amstan/binaryclock/doc/smpsu_design.pdf

## WEBENCH ® Design Report

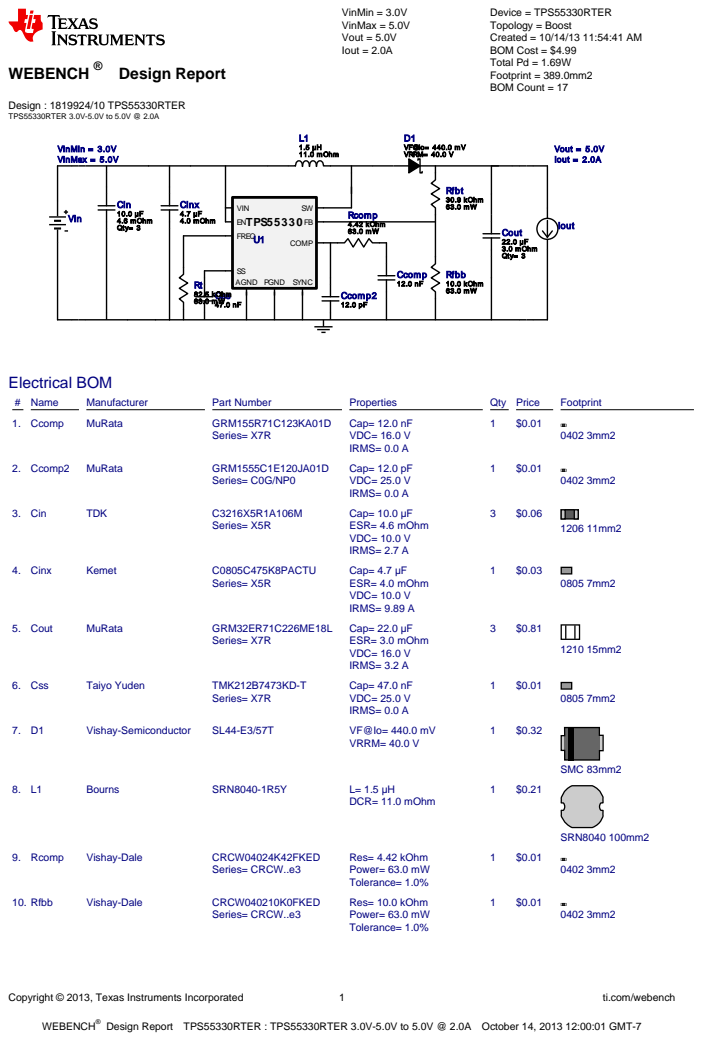
[picture p1: page 1]
Copyright © 2013, Texas Instruments Incorporated; ti.com/webench; WEBENCH®; Design : 1819924/10 TPS55330RTER TPS55330RTER 3.0V-5.0V to 5.0V @ 2.0A; VinMin = 3.0V VinMax = 5.0V Vout = 5.0V Iout = 2.0A; Device = TPS55330RTER Topology = Boost Created = 10/14/13 11:54:41 AM BOM Cost = $4.99 Total Pd = 1.69W Footprint = 389.0mm2 BOM Count = 17; Ccomp 12.0 nF; Ccomp2 12.0 pF; Cinx 4.7 µF 4.0 mOhm; Cout 22.0 µF 3.0 mOhm Qty= 3; Css 47.0 nF; D1 VF@Io= 440.0 mV VRRM= 40.0 V; L1 1.5 µH 11.0 mOhm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

Design Report TPS55330RTER : TPS55330RTER 3.0V-5.0V to 5.0V @ 2.0A October 14, 2013 12:00:01 GMT-7

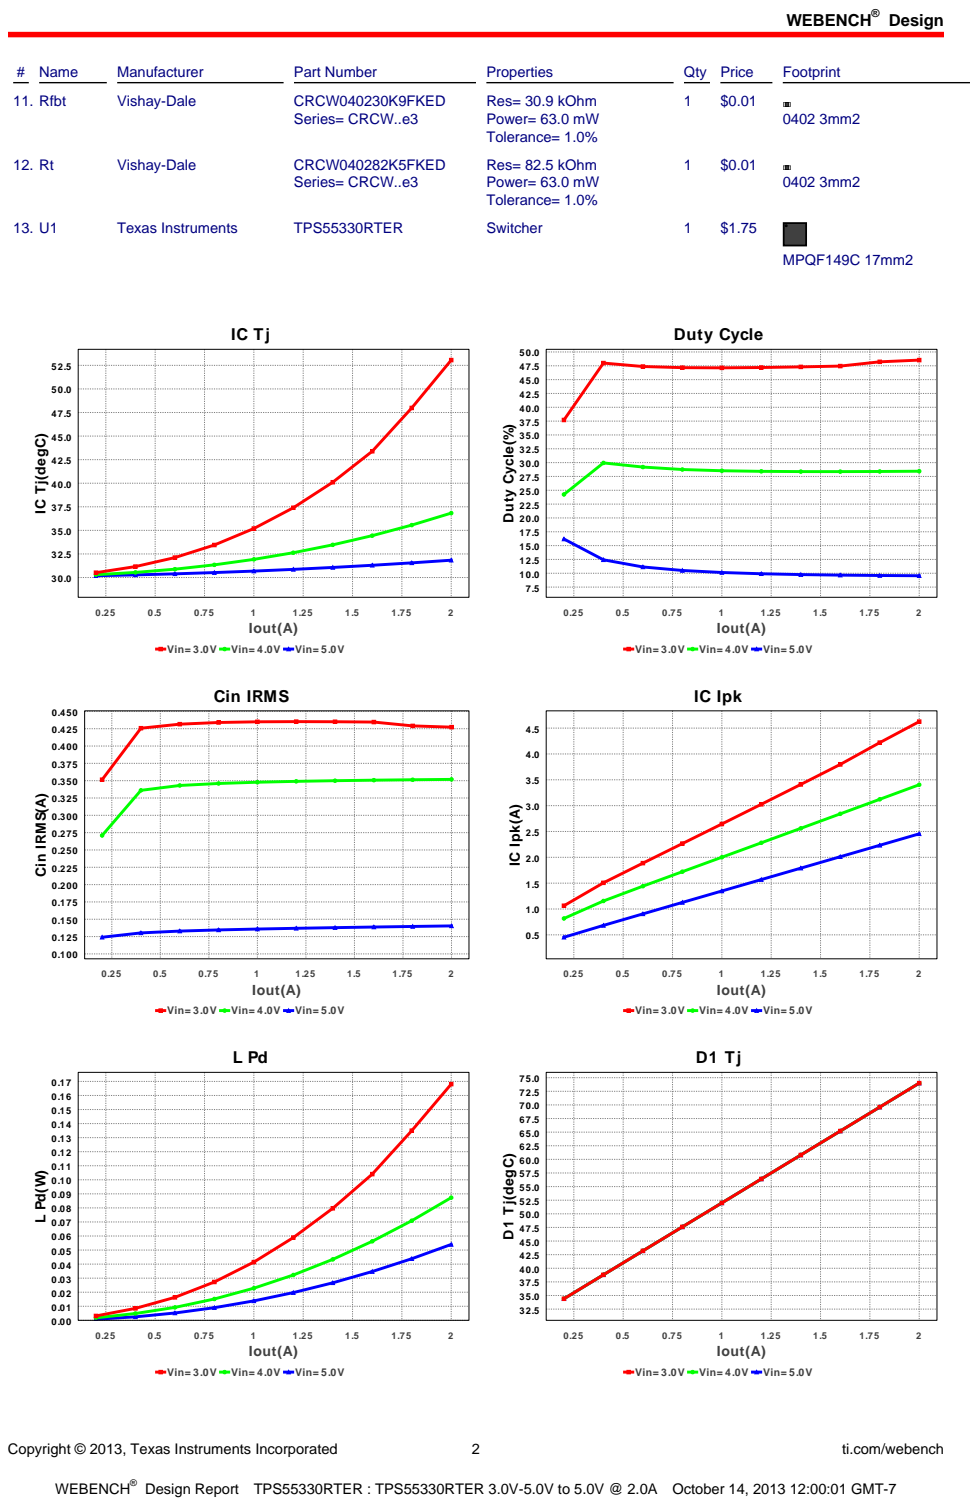
[picture p2: page 2]
Design; Copyright © 2013, Texas Instruments Incorporated; ti.com/webench; # Name; Manufacturer; Part Number; Properties; Qty Price; Footprint; 11. Rfbt; Vishay-Dale; CRCW040230K9FKED; Series= CRCW..e3; Res= 30.9 kOhm Power= 63.0 mW Tolerance= 1.0%; CRCW040282K5FKED; Res= 82.5 kOhm Power= 63.0 mW Tolerance= 1.0%; Texas Instruments; TPS55330RTER; Switcher; MPQF149C 17mm2; Iout(A); Duty Cycle; Duty Cycle(%); Cin IRMS; Cin IRMS(A); IC Ipk; IC Ipk(A); D1 Tj(degC)

IC Tj(degC)

Vin= 3.0V Vin= 4.0V Vin= 5.0V

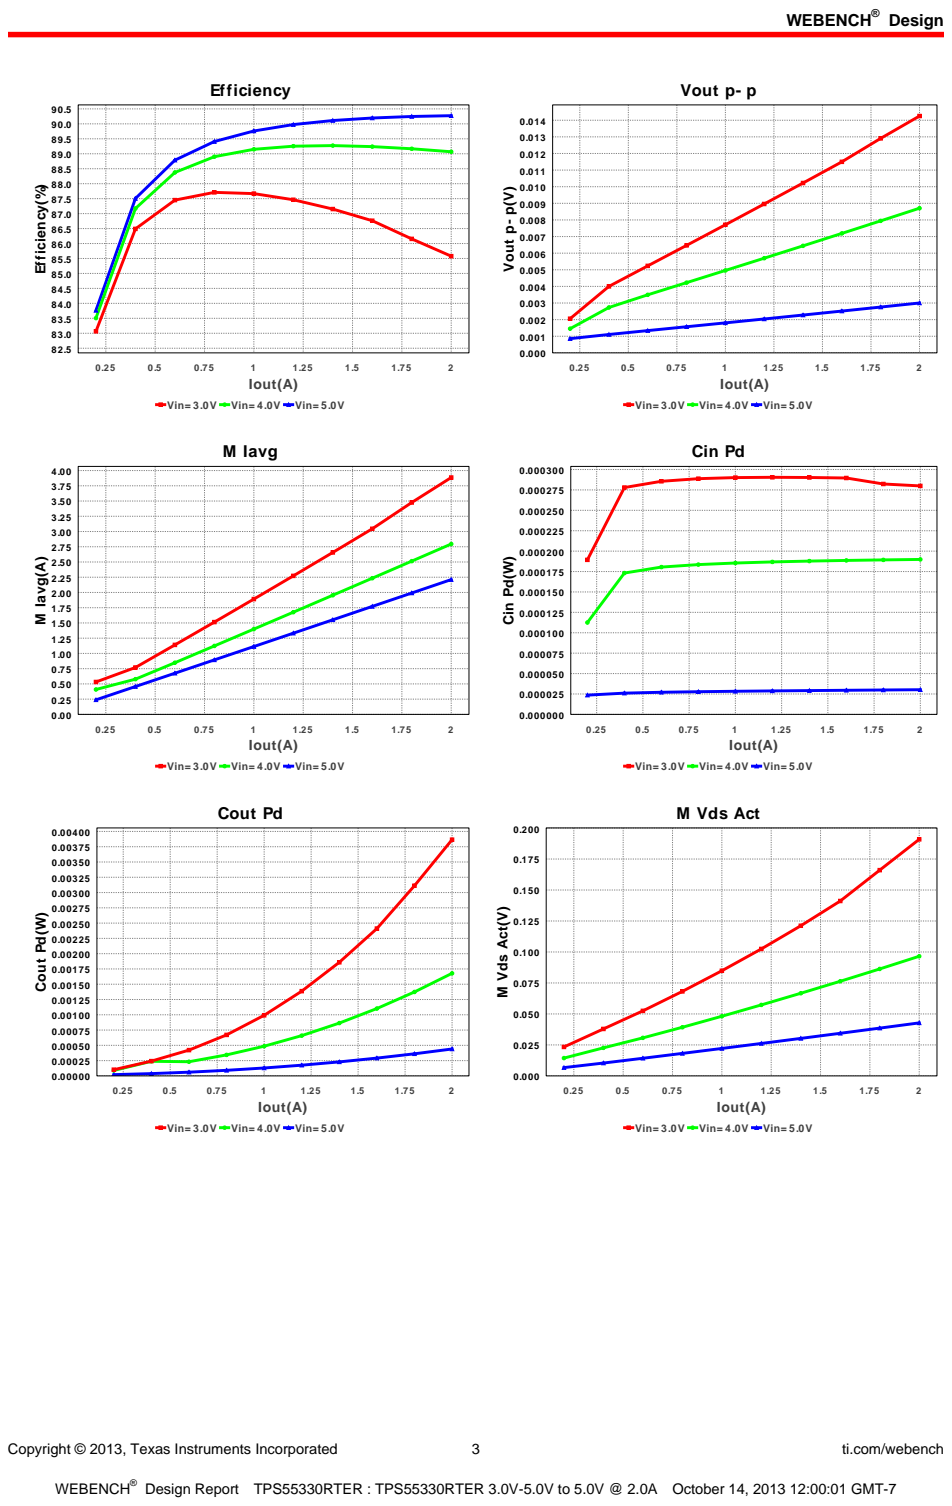
[picture p3: page 3]
Copyright © 2013, Texas Instruments Incorporated; ti.com/webench; Efficiency; Iout(A); Efficiency(%); Vout p- p; Vout p- p(V); M Iavg; M Iavg(A); Cin Pd; Cin Pd(W); Cout Pd; Cout Pd(W); M Vds Act; M Vds Act(V)

Vin= 3.0V Vin= 4.0V Vin= 5.0V

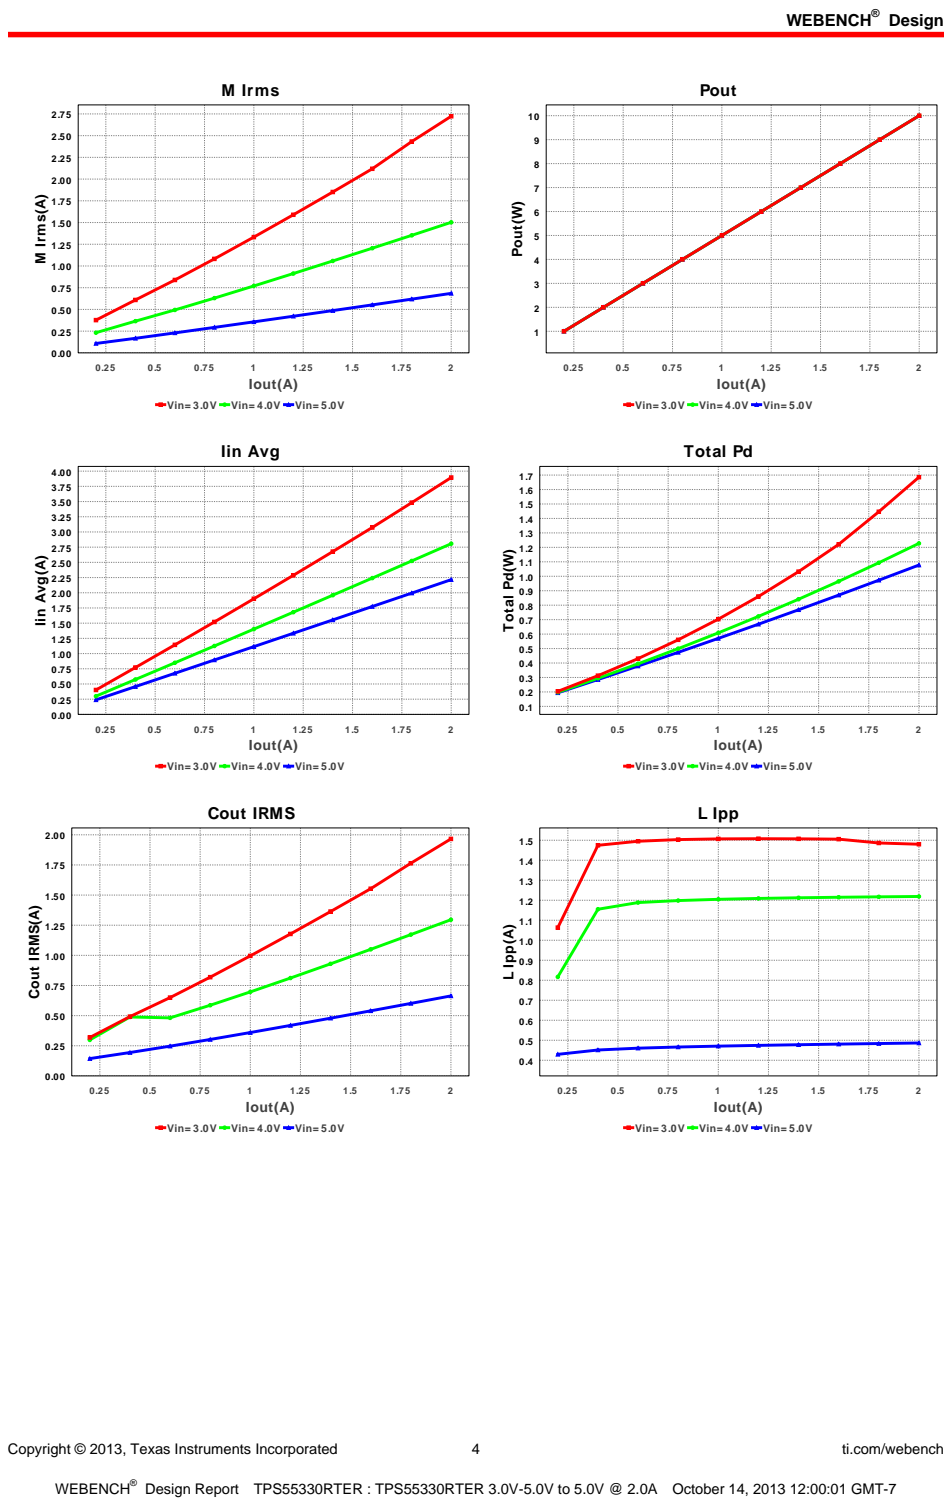
[picture p4: page 4]
Copyright © 2013, Texas Instruments Incorporated; ti.com/webench; M Irms; Iout(A); M Irms(A); Pout; Pout(W); Iin Avg; Iin Avg(A); Total Pd; Total Pd(W); Cout IRMS; Cout IRMS(A); L Ipp; L Ipp(A)

Vin= 3.0V Vin= 4.0V Vin= 5.0V

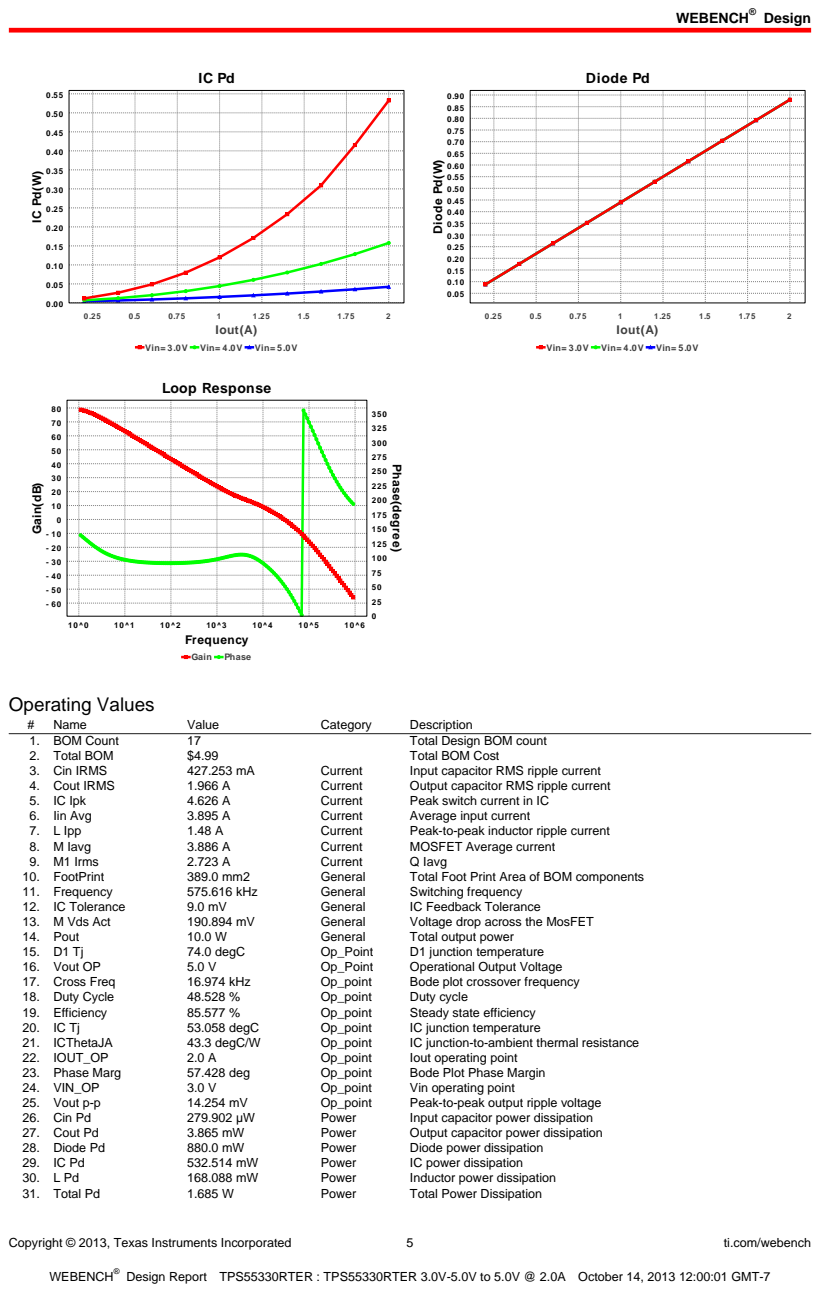
[picture p5: page 5]
Copyright © 2013, Texas Instruments Incorporated; ti.com/webench; Iout(A); Diode Pd; Diode Pd(W); Loop Response; Gain Phase; 10^6 Frequency; Gain(dB); Phase(degree); Operating Values; Name; Value; Category; Description; 1. BOM Count; Total Design BOM count; 2. Total BOM; Total BOM Cost; 3. Cin IRMS; Current; Input capacitor RMS ripple current; 4. Cout IRMS; Output capacitor RMS ripple current; 5. IC Ipk; Peak switch current in IC; 6. Iin Avg; Average input current; 7. L Ipp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

Vin= 3.0V Vin= 4.0V Vin= 5.0V

Copyright © 2013, Texas Instruments Incorporated | 6 | ti.com/webench

## Design Inputs

# | Name | Value | Description

1. Iout | 2.0 A | Maximum Output Current
2. Iout1 | 2.0 Amps | Output Current #1
3. VinMax | 5.0 V | Maximum input voltage
4. VinMin | 3.0 V | Minimum input voltage
5. Vout | 5.0 V | Output Voltage
6. Vout1 | 5.0 Volt | Output Voltage #1
7. base_pn | TPS55330 | Base Product Number
8. source | DC | Input Source Type
9. Ta | 30.0 degC | Ambient temperature

## Design Assistance

1. TPS55330 Product Folder : http://www.ti.com/product/tps55330 : contains the data sheet and other resources.

Texas Instruments' WEBENCH simulation tools attempt to recreate the performance of a substantially equivalent physical implementation
of the design. Simulations are created using Texas Instruments' published specifications as well as the published specifications of other device manufacturers. While Texas Instruments does update this information periodically, this information may not be current at the time the simulation is built. Texas Instruments does not warrant the accuracy or completeness of the specifications or any information contained therein. Texas Instruments does not warrant that any designs or recommended parts will meet the specifications you entered, will be suitable for your application or fit for any particular purpose, or will operate as shown in the simulation in a physical implementation. Texas Instruments does not warrant that the designs are production worthy.
You should completely validate and test your design implementation to confirm the system functionality for your application prior to production.
Use of Texas Instruments' WEBENCH simulation tools is subject to Texas Instruments' Site Terms and Conditions of Use. (http://www.ti.com/corp/docs/legal/termsofuse.shtml) Prototype boards based on WEBENCH created designs are provided AS IS without warranty of any kind for evaluation and testing purposes and are subject to the terms of the Evaluation License Agreement. (http://www.ti.com/corp/docs/legal/termsofuse_estore.shtml)
