amstan/binaryclock/doc/olimexino-5510.pdf

# POWER_SUPPLY

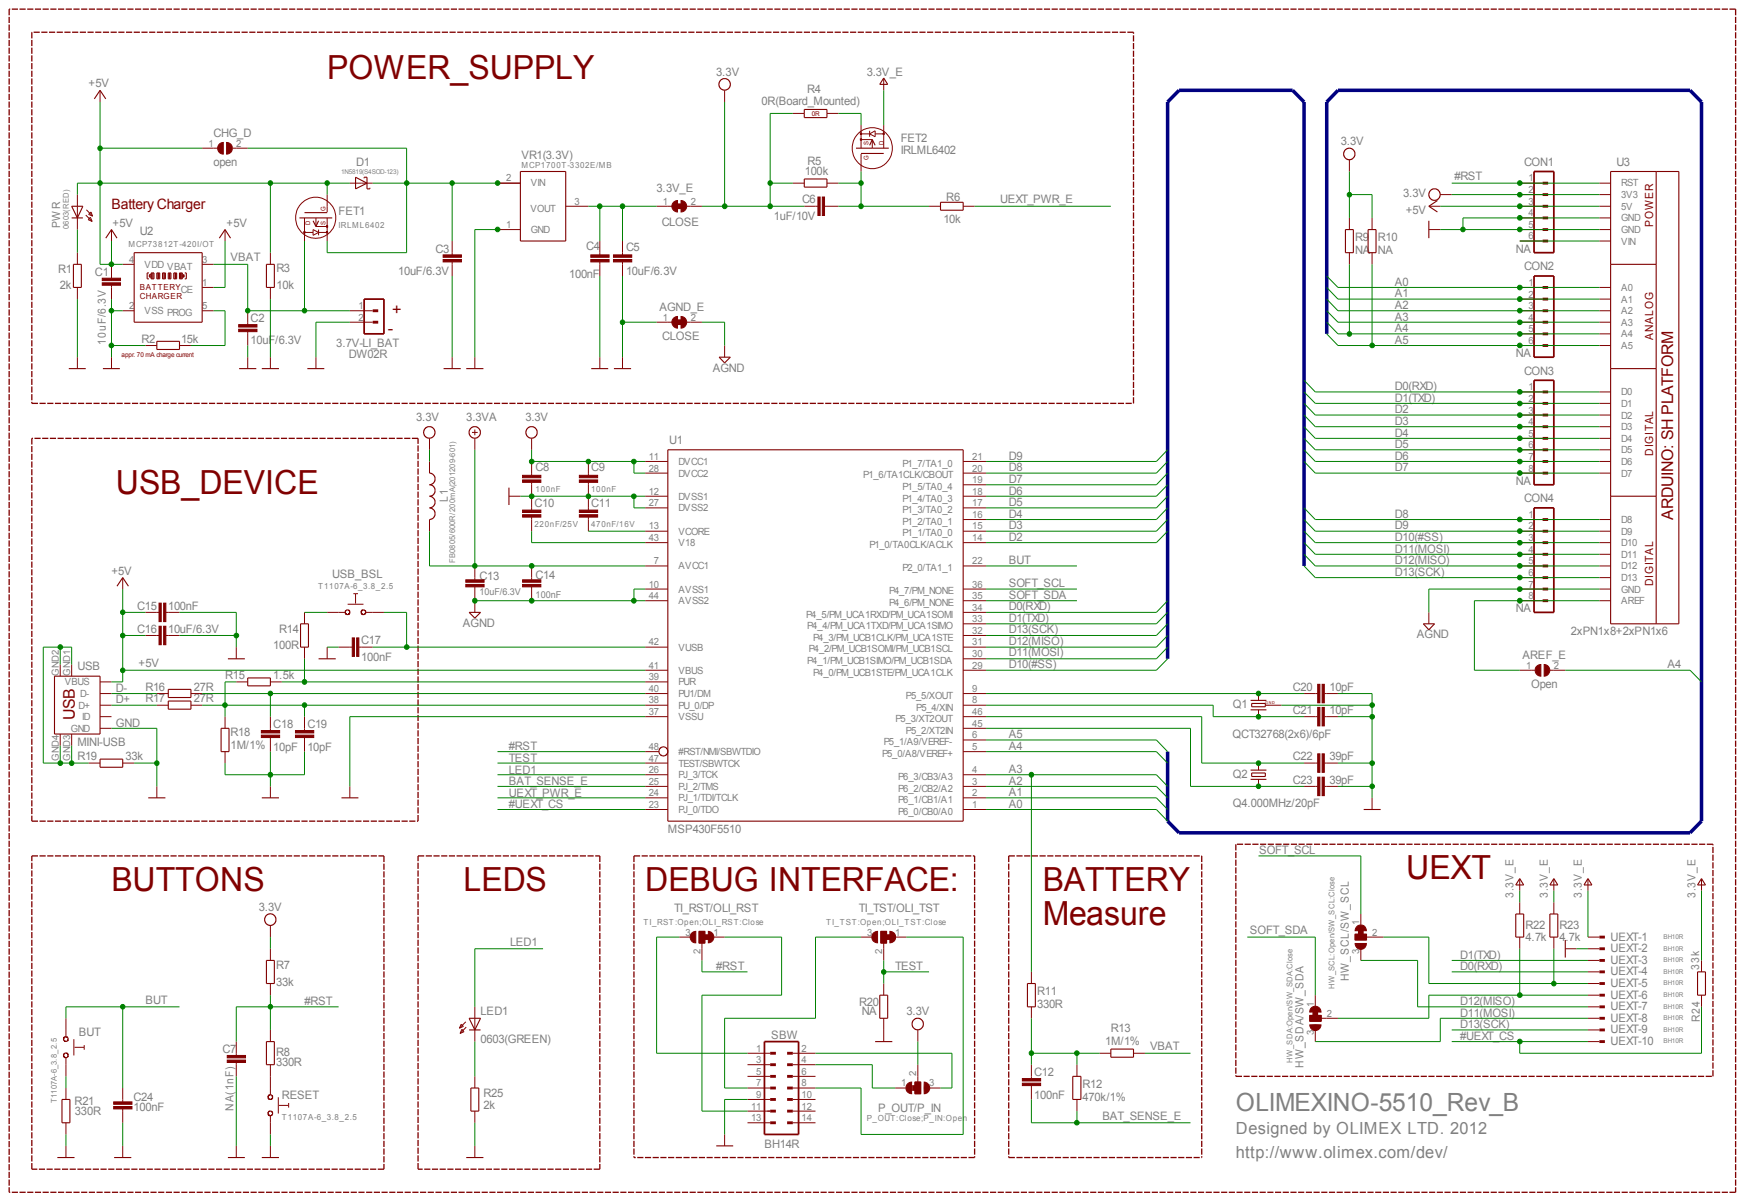
[picture p6: page 1]

POWER ANALOG DIGITAL DIGITAL

Battery Charger +5V +5V | FET1 | GND 1

appr. 70 mA charge current

#RST/NMI/SBWTDIO 48 TEST/SBWTCK 47 PJ_0/TDO 23 PJ_1/TDI/TCLK 24 PJ_2/TMS 25 PJ_3/TCK 26 | QCT32768(2x6)/6pF

MINI-USB R19 33k

OLIMEXINO-5510_Rev_B
Designed by OLIMEX LTD. 2012
http://www.olimex.com/dev/
