amstan/binaryclock/eagle/pdf/clock.brd.pdf

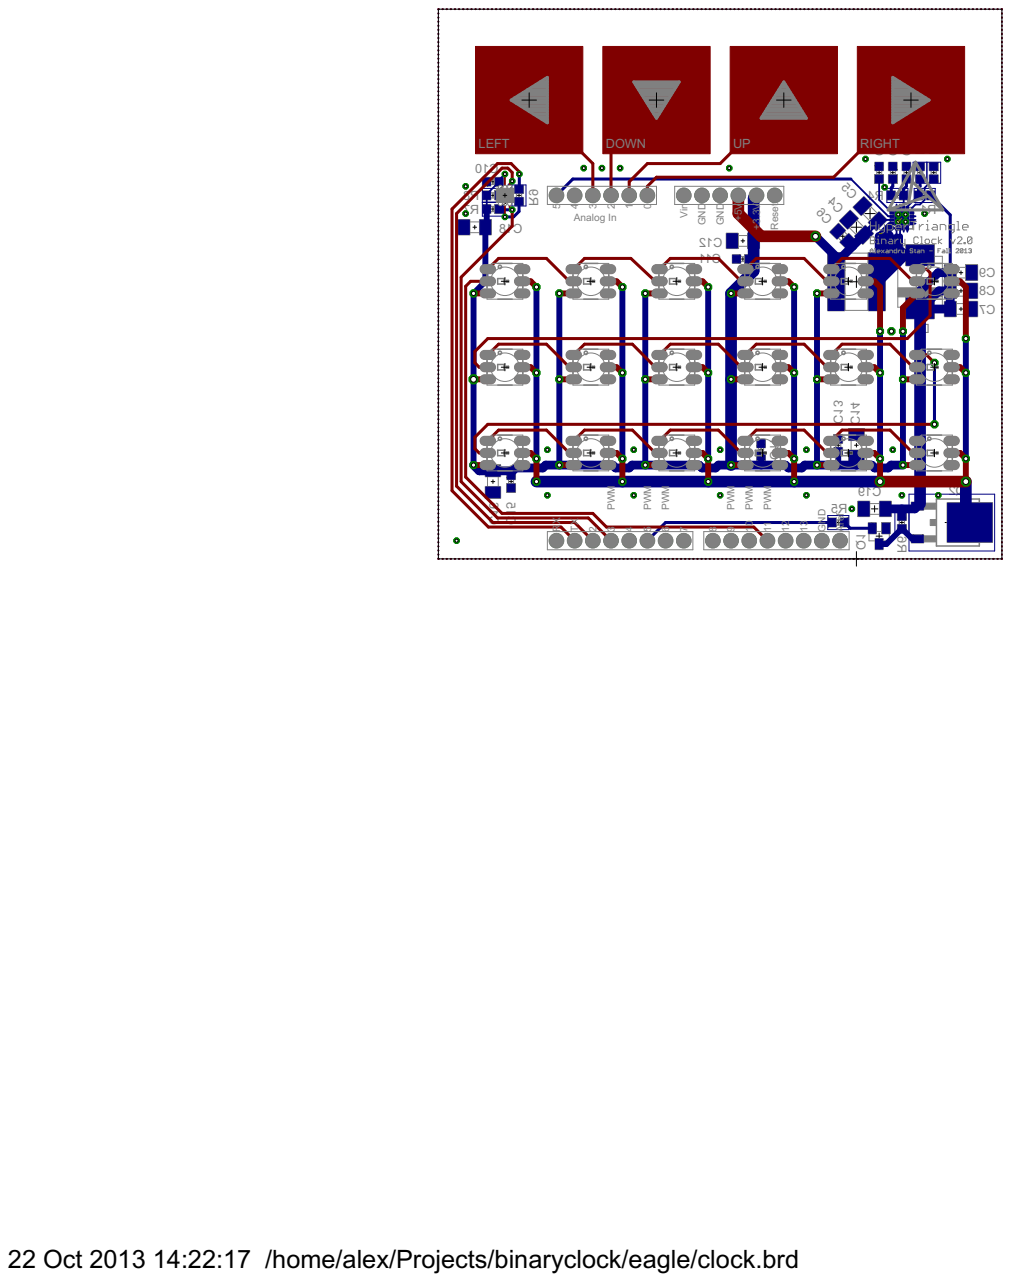
[picture p7: page 1]

22 Oct 2013 14:22:17 /home/alex/Projects/binaryclock/eagle/clock.brd
