amstan/binaryclock/eagle/pdf/clock.sch.pdf

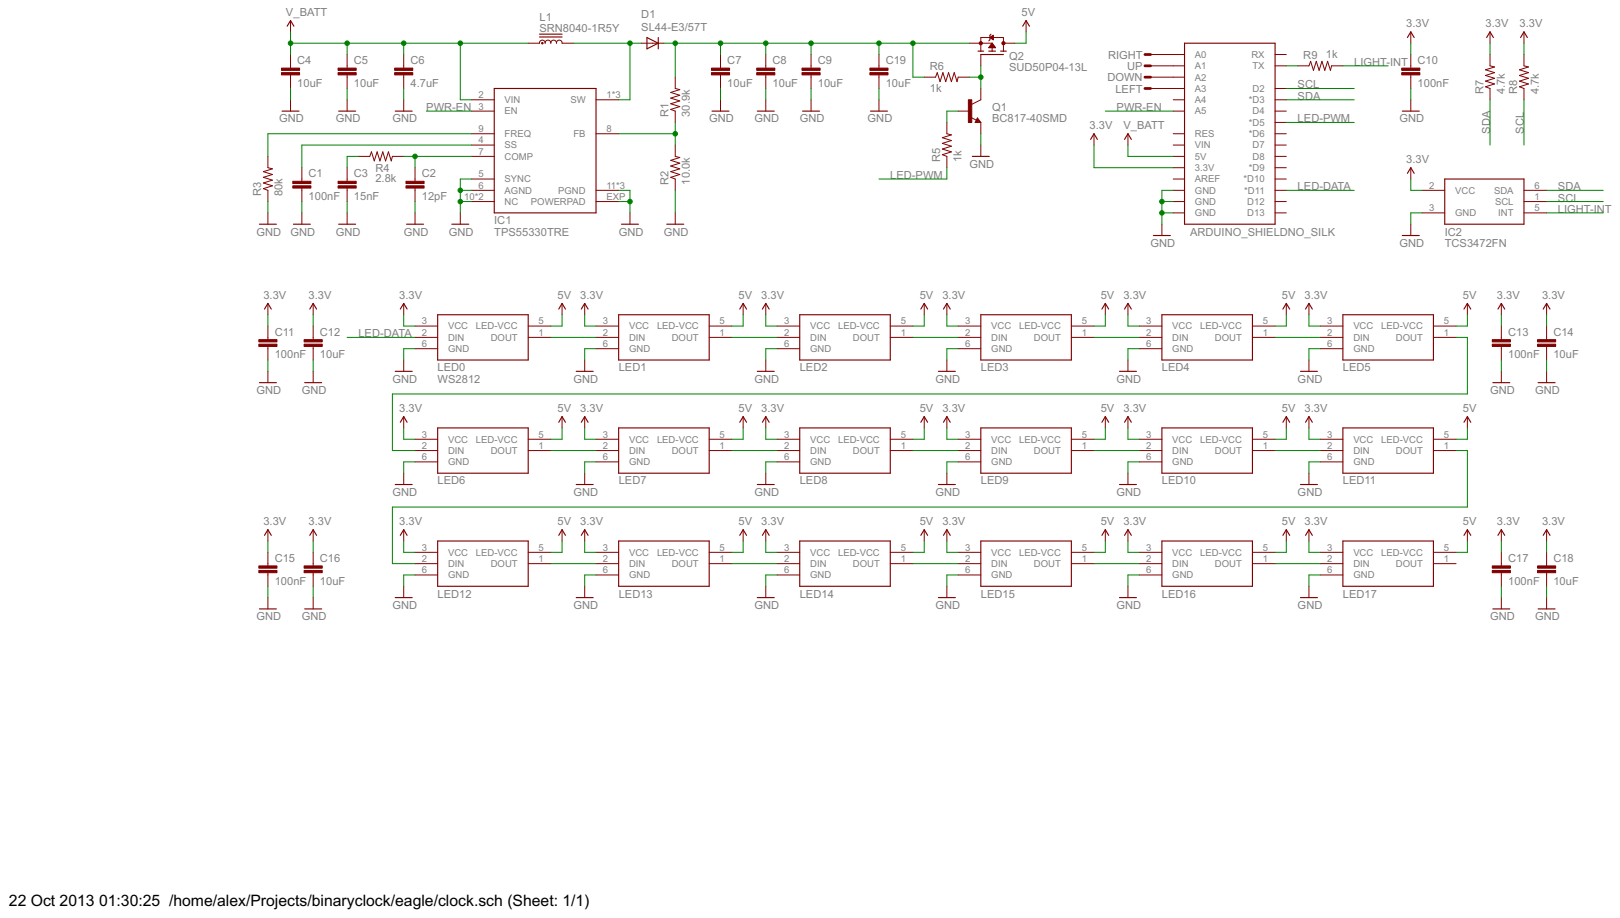
[picture p8: page 1]

22 Oct 2013 01:30:25 /home/alex/Projects/binaryclock/eagle/clock.sch (Sheet: 1/1)
