amstan/binaryclock/eagle/clock.brd

## EAGLE design eagle/clock.brd (2013-10-22)

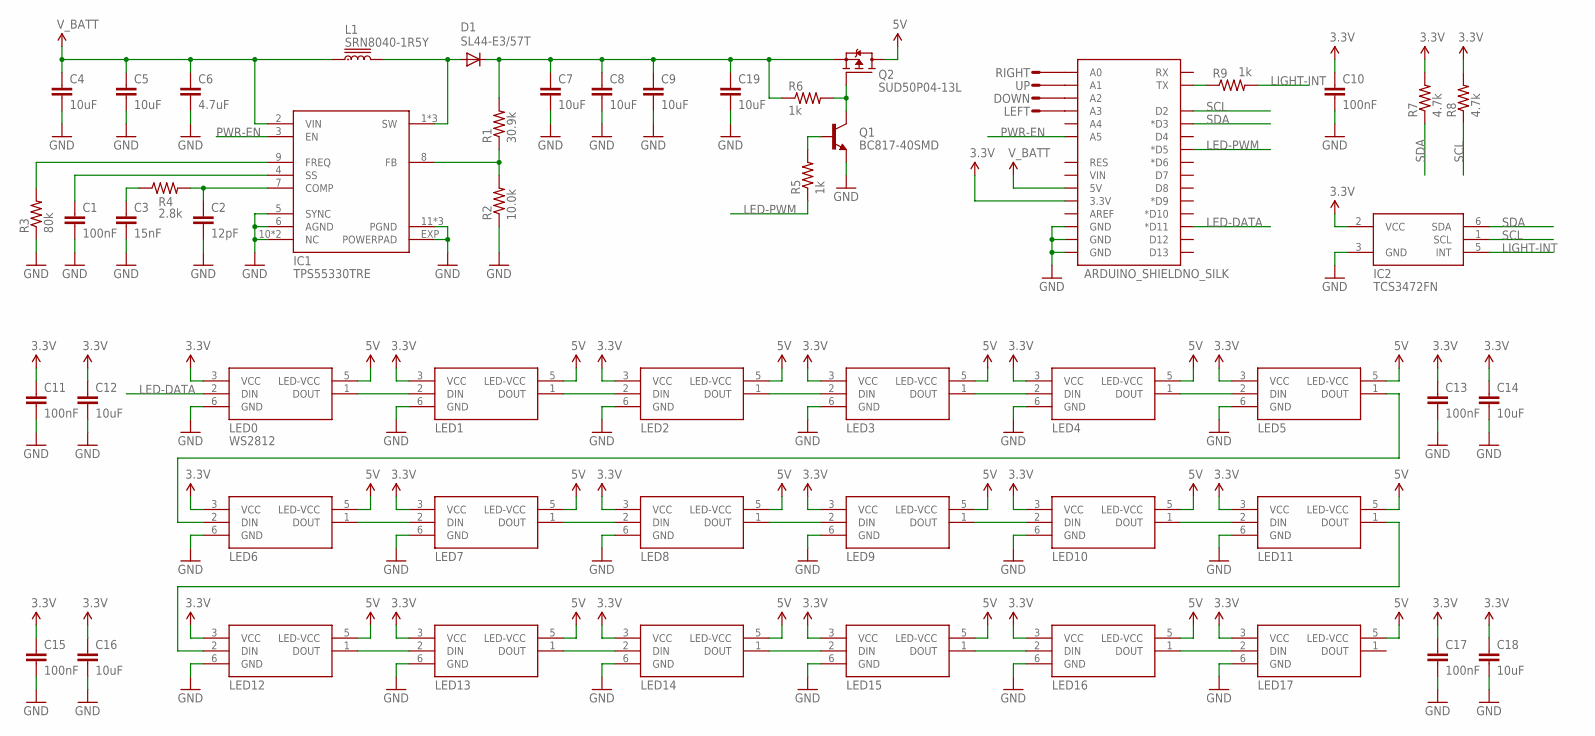
[picture p9: schematic clock.sch]

Parts:
C1, C10, C11, C13, C15, C17: 100nF; C0603K
C2: 12pF; C0603K
C3: 15nF; C0603K
C4, C5, C7, C8, C9, C12, C14, C16, C18, C19: 10uF; C1206K
C6: 4.7uF; C0805K
CN1: ARDUINO_SHIELDNO_SILK; DUEMILANOVE_VIAS
D1: SL44-E3/57T; SMC
DOWN: CAP-PAD15MM; CAP-PAD-15MM
IC1: TPS55330TRE; QFN16
IC2: TCS3472FN; DFN-6
L1: SRN8040-1R5Y; SRN8040
LED0, LED1, LED2, LED3, LED4, LED5, LED6, LED7, LED8, LED9, LED10, LED11, LED12, LED13, LED14, LED15, LED16, LED17: WS2812; LED-TRICOLOR-5050-IC
LEFT: CAP-PAD15MM; CAP-PAD-15MM
Q1: BC817-40SMD; SOT23-BEC
Q2: SUD50P04-13L; TO252
R1: 30.9k; R0603
R2: 10.0k; R0603
R3: 80k; R0603
R4: 2.8k; R0603
R5, R6, R9: 1k; R0603
R7, R8: 4.7k; R0603
RIGHT: CAP-PAD15MM; CAP-PAD-15MM
UP: CAP-PAD15MM; CAP-PAD-15MM

Connections:
3.3V: C10.1, C11.1, C12.1, C13.1, C14.1, C15.1, C16.1, C17.1, C18.1, CN1.3.3V, IC2.2 (VCC), LED0.3 (VCC), LED1.3 (VCC), LED2.3 (VCC), LED3.3 (VCC), LED4.3 (VCC), LED5.3 (VCC), LED6.3 (VCC), LED7.3 (VCC), LED8.3 (VCC), LED9.3 (VCC), LED10.3 (VCC), LED11.3 (VCC), LED12.3 (VCC), LED13.3 (VCC), LED14.3 (VCC), LED15.3 (VCC), LED16.3 (VCC), LED17.3 (VCC), R7.2, R8.2
5V: LED0.5 (LED-VCC), LED1.5 (LED-VCC), LED2.5 (LED-VCC), LED3.5 (LED-VCC), LED4.5 (LED-VCC), LED5.5 (LED-VCC), LED6.5 (LED-VCC), LED7.5 (LED-VCC), LED8.5 (LED-VCC), LED9.5 (LED-VCC), LED10.5 (LED-VCC), LED11.5 (LED-VCC), LED12.5 (LED-VCC), LED13.5 (LED-VCC), LED14.5 (LED-VCC), LED15.5 (LED-VCC), LED16.5 (LED-VCC), LED17.5 (LED-VCC), Q2.3 (D)
COMP: C2.1, IC1.7 (COMP), R4.2
FB: IC1.8 (FB), R1.1, R2.2
FREQ: IC1.9 (FREQ), R3.2
GND: C1.2, C2.2, C3.2, C4.2, C5.2, C6.2, C7.2, C8.2, C9.2, C10.2, C11.2, C12.2, C13.2, C14.2, C15.2, C16.2, C17.2, C18.2, C19.2, CN1.GND@0 (GND), CN1.GND@1 (GND), CN1.GND@2 (GND), IC1.5 (SYNC), IC1.6 (AGND), IC1.10 (NC), IC1.11 (PGND), IC1.12 (PGND), IC1.13 (PGND), IC1.14 (NC), IC1.EXP (POWERPAD), IC2.3 (GND), LED0.6 (GND), LED1.6 (GND), LED2.6 (GND), LED3.6 (GND), LED4.6 (GND), LED5.6 (GND), LED6.6 (GND), LED7.6 (GND), LED8.6 (GND), LED9.6 (GND), LED10.6 (GND), LED11.6 (GND), LED12.6 (GND), LED13.6 (GND), LED14.6 (GND), LED15.6 (GND), LED16.6 (GND), LED17.6 (GND), Q1.E, R2.1, R3.1
LED12: LED12.1 (DOUT), LED13.2 (DIN)
LED15: LED14.1 (DOUT), LED15.2 (DIN)
LED-DATA: CN1.D11 (*D11), LED0.2 (DIN)
LED-PWM: CN1.D5 (*D5), R5.1
LIGHT-INT: IC2.5 (INT), R9.2
unnamed: CN1.A3, LEFT.P$1
unnamed: CN1.A2, DOWN.P$1
unnamed: CN1.A1, UP.P$1
unnamed: CN1.A0, RIGHT.P$1
unnamed: LED0.1 (DOUT), LED1.2 (DIN)
unnamed: CN1.TX, R9.1
unnamed: C3.1, R4.1
unnamed: Q1.B, R5.2
unnamed: Q1.C, Q2.1 (G), R6.2
unnamed: LED1.1 (DOUT), LED2.2 (DIN)
unnamed: LED2.1 (DOUT), LED3.2 (DIN)
unnamed: LED3.1 (DOUT), LED4.2 (DIN)
unnamed: LED4.1 (DOUT), LED5.2 (DIN)
unnamed: LED6.1 (DOUT), LED7.2 (DIN)
unnamed: LED7.1 (DOUT), LED8.2 (DIN)
unnamed: LED8.1 (DOUT), LED9.2 (DIN)
unnamed: LED9.1 (DOUT), LED10.2 (DIN)
unnamed: LED10.1 (DOUT), LED11.2 (DIN)
unnamed: LED5.1 (DOUT), LED6.2 (DIN)
unnamed: LED13.1 (DOUT), LED14.2 (DIN)
unnamed: LED15.1 (DOUT), LED16.2 (DIN)
unnamed: LED16.1 (DOUT), LED17.2 (DIN)
unnamed: LED11.1 (DOUT), LED12.2 (DIN)
PWR-EN: CN1.A5, IC1.3 (EN)
SCL: CN1.D2, IC2.1 (SCL), R8.1
SDA: CN1.D3 (*D3), IC2.6 (SDA), R7.1
SMPSU-OUTPUT: C7.1, C8.1, C9.1, C19.1, D1.C, Q2.2 (S), R1.2, R6.1
SS: C1.1, IC1.4 (SS)
SW: D1.A, IC1.1 (SW), IC1.15 (SW), IC1.16 (SW), L1.P$2 (2)
V_BATT: C4.1, C5.1, C6.1, CN1.5V, IC1.2 (VIN), L1.P$1 (1)

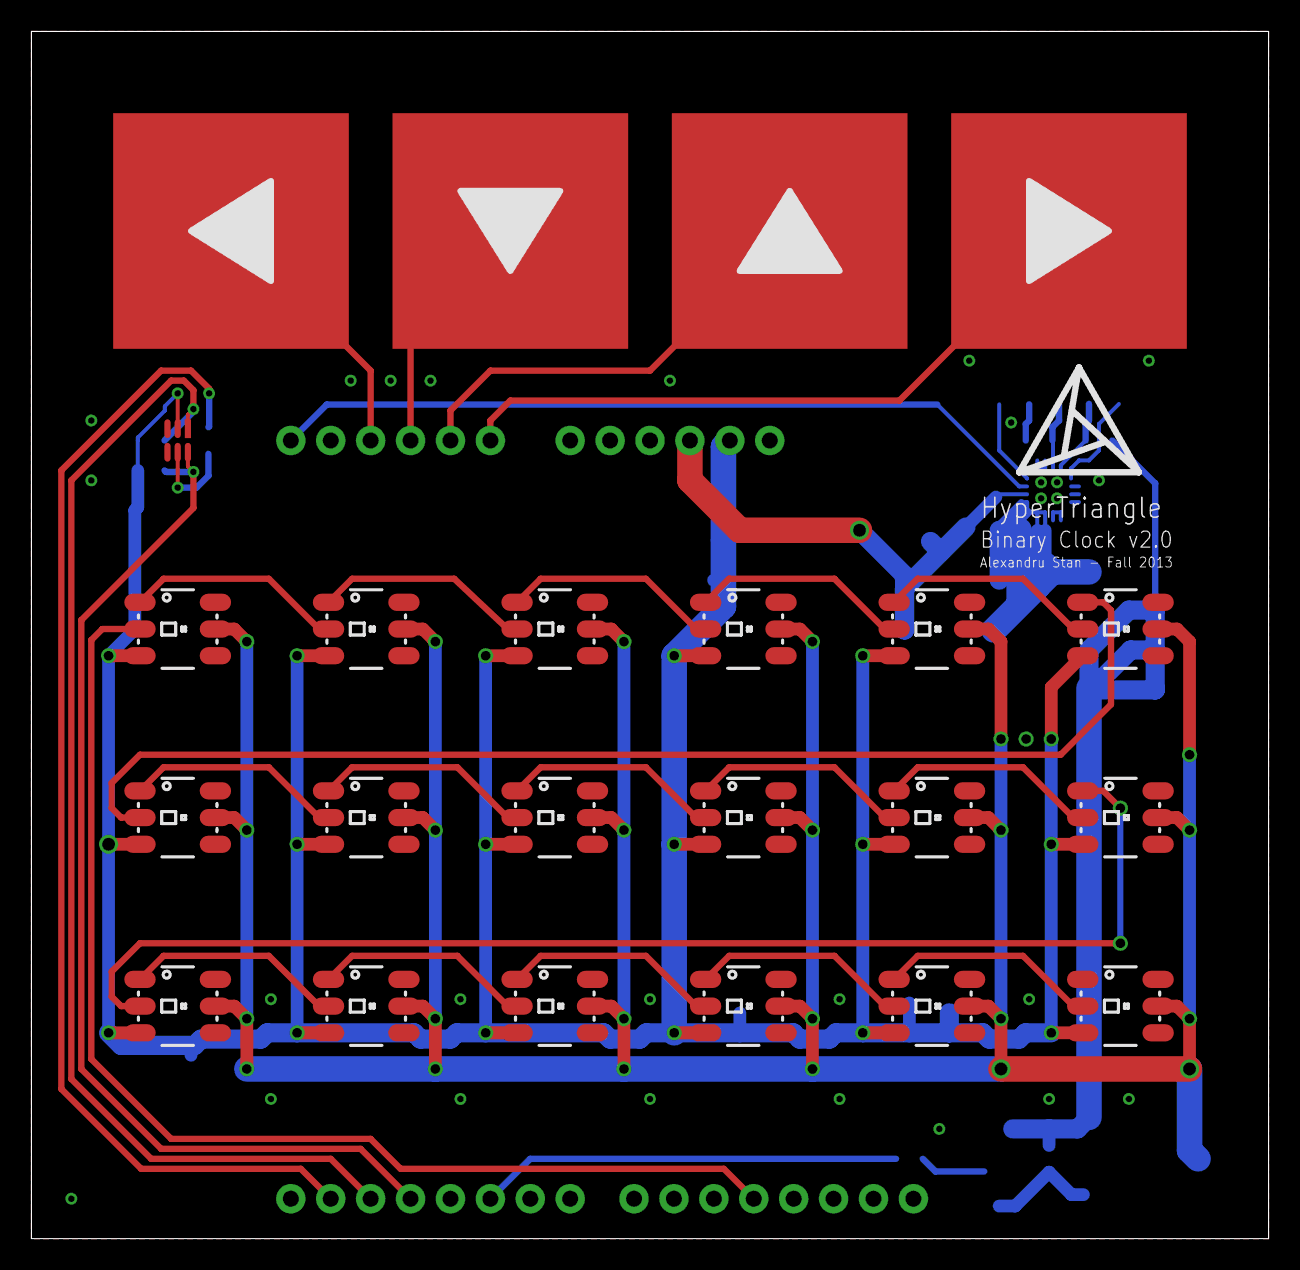
[picture p10: board clock.brd from above]

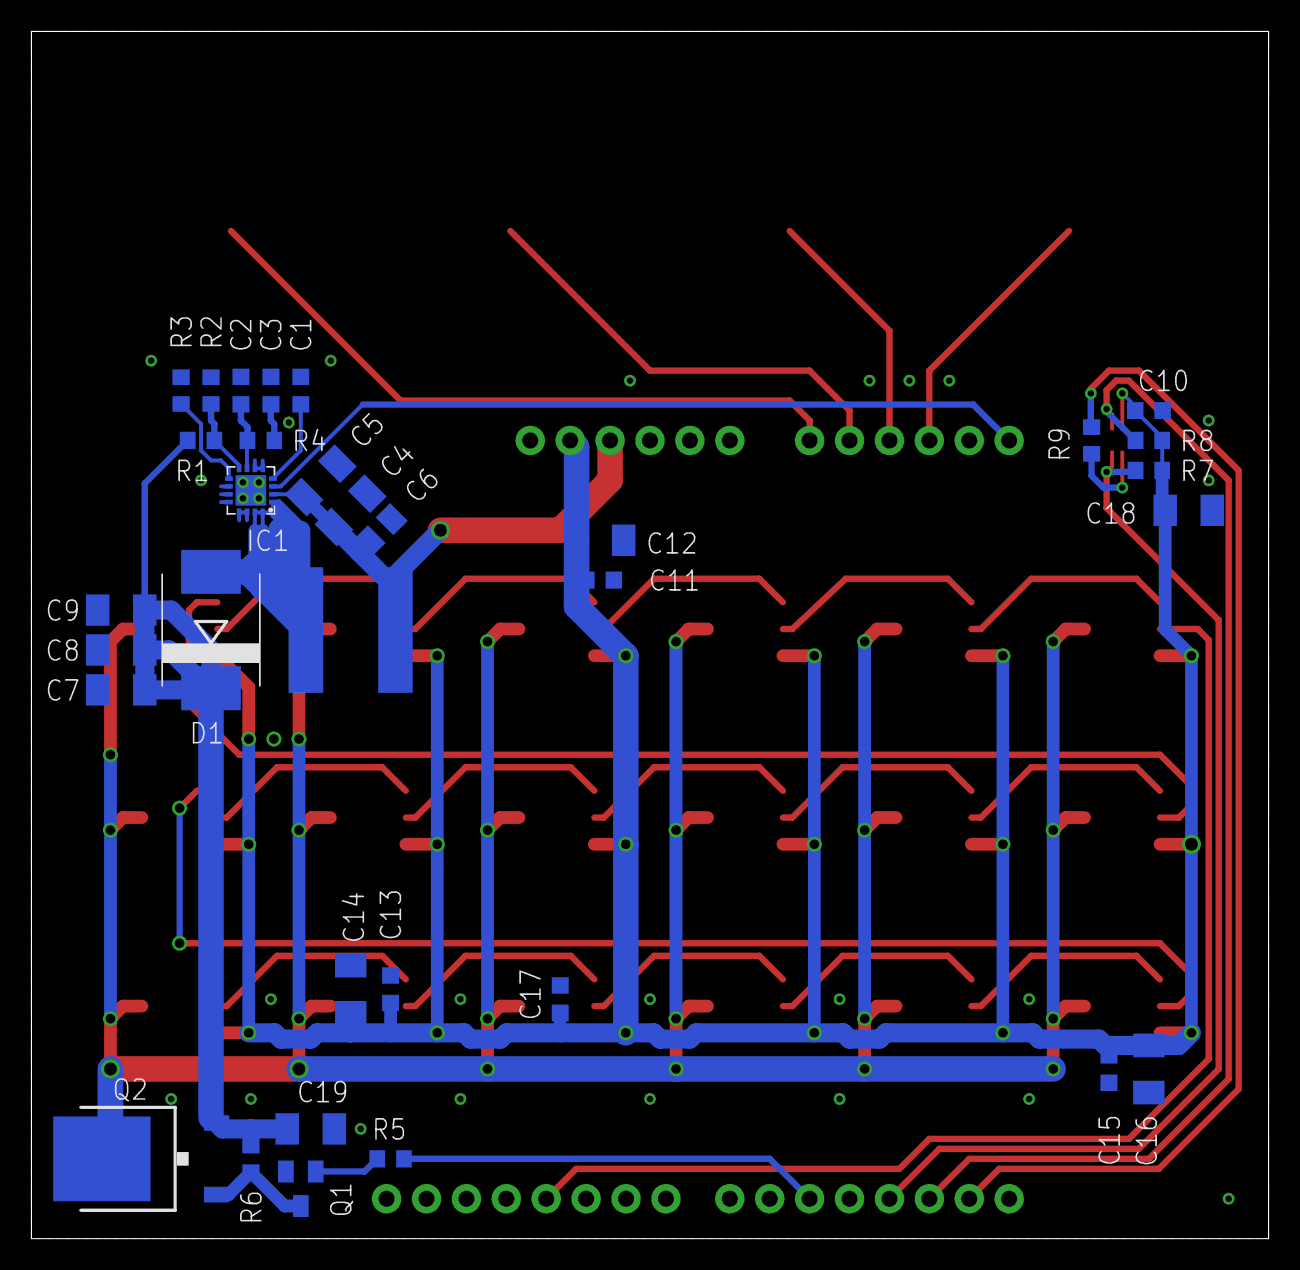
[picture p11: board clock.brd from below]

Board: 2 copper layers, 78.7 x 76.8 mm, 57 parts (33 on the bottom side), 41 nets.
