amstan/binaryclock/firmware/util.h

#pragma once

void core_frequency_set(unsigned long int frequency) {
	///Set multiplier based on the slow xtal
	UCSCTL3 |= SELREF_2;
	UCSCTL4 |= SELA_2;
	UCSCTL0 = 0x0000;
	UCSCTL1 = DCORSEL_5;
	UCSCTL2 = FLLD_1 + (frequency/32768)-1;
}
