amstan/binaryclock/(commit log)

2013-10-21 created folder structure
    [clock.sch]
2013-10-21 Redesigned schematic. Moved from upverter.
    [clock.sch]
2013-10-22 started work on the layout. PSU is layed out too
    [clock.brd, clock.sch]
2013-10-22 came up with a better location for the buttons
    [clock.brd, clock.sch]
2013-10-22 Almost finished layout
    [clock.brd, clock.sch]
2013-10-22 Seems like there's a bug with the polyfills in eagle. I gave up and I just used one back plane
    [clock.brd]
2013-10-22 Finished silk screen touches. Ready to order.
    [clock.brd]
2013-10-22 Ready to order
    [clock.GBL, clock.GBO, clock.GBS, clock.GKO, clock.GTL, clock.GTO, clock.GTS, clock.XLN]
2013-11-19 preliminary RGB clock to test the finished board
2013-11-23 Organized code, added usb, added capacitive touch(really finicky)
2013-11-23 Moved capacitive touch to another timer, implemented LED-PWM(unfortunatelly hardware does not support the high frequencies)
2013-11-23 not having much luck with i2c yet
