amstan/binaryclock/(notices)

Notices in the files:
parts and their libraries:
HyperTriangle: Copyright HyperTriangle 2010-2011
SparkFun-Aesthetics: Licensing: CC v3.0 Share-Alike You are welcome to use this library for commercial purposes.
